diegoargiles/rescu-structures/reports/baseline/load_cases.csv

case | foam | skin_mm | half_force_limit_N | root_moment_limit_Nm | tip_bend_limit_mm | tip_shear_limit_mm | tip_total_limit_mm | tip_twist_limit_deg | max_face_stress_ultimate_MPa | max_torsion_shear_ultimate_MPa | ply_failure_index_ultimate | core_shear_utilization_ultimate | spar_bending_utilization_ultimate | deflection_screen_utilization | twist_screen_utilization | screen_status | overall_status
Wing 3g | Ravatherm XPS X H LB | 0.33 | 55.88340259360954 | 16.598035799563814 | 19.75474637168348 | 4.064735941685093 | 23.819482313368578 | -1.4404386216758196 | 18.46394922169429 | 3.272280001880612 | 0.2927211461975924 | 0.6933226082319038 | 0.42495801101249625 | 0.6805566375248164 | 0.7202193108379098 | PASS | UNRESOLVED: CAD profile, joints, wrinkling, shell and load envelope
Wing -1.5g | Ravatherm XPS X H LB | 0.33 | -27.94170129680477 | -8.299017899781907 | -9.87737318584174 | -2.0323679708425466 | -11.909741156684289 | -0.7704705724954126 | 9.231974610847145 | 1.6300208546258261 | 0.14559914323271644 | 0.3466613041159519 | 0.21247900550624813 | 0.3402783187624082 | 0.3852352862477063 | PASS | UNRESOLVED: CAD profile, joints, wrinkling, shell and load envelope
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
