diegoargiles/rescu-structures/reports/connection_study/attachment_loads.csv

T_N | case | front_N | rear_N | force_on_wing_A_N | force_on_wing_B_N | max_abs_support_N
17.3 | both | 17.3 | 17.3 | 9.885714285714286 | 24.714285714285715 | 24.714285714285715
17.3 | front_only | 17.3 | 0 | 58.078571428571436 | -40.77857142857143 | 58.078571428571436
17.3 | rear_only | 0 | 17.3 | -48.19285714285715 | 65.49285714285715 | 65.49285714285715
17.3 | front_full_rear_half | 17.3 | 8.65 | 33.98214285714286 | -8.032142857142857 | 33.98214285714286
17.3 | front_half_rear_full | 8.65 | 17.3 | -19.153571428571425 | 45.10357142857143 | 45.10357142857143
26.0 | both | 26.0 | 26.0 | 14.857142857142854 | 37.142857142857146 | 37.142857142857146
26.0 | front_only | 26.0 | 0 | 87.28571428571428 | -61.285714285714285 | 87.28571428571428
26.0 | rear_only | 0 | 26.0 | -72.42857142857143 | 98.42857142857143 | 98.42857142857143
26.0 | front_full_rear_half | 26.0 | 13.0 | 51.07142857142857 | -12.071428571428571 | 51.07142857142857
26.0 | front_half_rear_full | 13.0 | 26.0 | -28.785714285714292 | 67.78571428571429 | 67.78571428571429
