diegoargiles/rescu-structures/reports/r13/arm_load_comparison.csv

revision | case | Ffront_limit_N | Frear_limit_N | RA_limit_N | RB_limit_N | max_bending_limit_Nm | section_I_mm4 | axial_stress_limit_MPa | axial_stress_ultimate_MPa | tube_pair_mass_g_rho1600 | front_deflection_mm_E40 | rear_deflection_mm_E40 | front_deflection_mm_E70 | rear_deflection_mm_E70
R12 | balanced_max | 17.3 | 17.3 | 4.942857142857143 | 29.65714285714286 | 2.595 | 12072.0 | 3.224403578528827 | 4.836605367793241 | 107.52000000000001 | 0.02657147393417275 | 0.065383739231279 | 0.015183699390955846 | 0.037362136703588
R12 | front_only | 17.3 | 0 | 42.01428571428572 | -24.714285714285715 | 1.73 | 12072.0 | 2.149602385685885 | 3.224403578528827 | 107.52000000000001 | 0.020301800309255588 | 0.006269673624917149 | 0.011601028748146044 | 0.0035826706428097946
R12 | rear_only | 0 | 17.3 | -37.07142857142857 | 54.371428571428574 | 2.595 | 12072.0 | 3.224403578528827 | 4.836605367793241 | 107.52000000000001 | 0.006269673624917161 | 0.059114065606361815 | 0.0035826706428098085 | 0.03377946606077818
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
