diegoargiles/rescu-structures/archive/v2_v3/ARCHIVE.md

# Historical V2 / H60 V3 reference

These files were moved unchanged from the previous repository root when V4 became current. They document older configurations and are not the current mass/geometry baseline. The old README's branch and run instructions describe that historical state.

Run the current root-level RescU_Structures_V4.py instead. If reproducing the archived V3 tests, change into this directory first, then run `python -m unittest test_v3 -v` so its local imports and airfoil paths resolve.
