diegoargiles/rescu-structures/cad/r13/RescU_R13_New_Parts.step

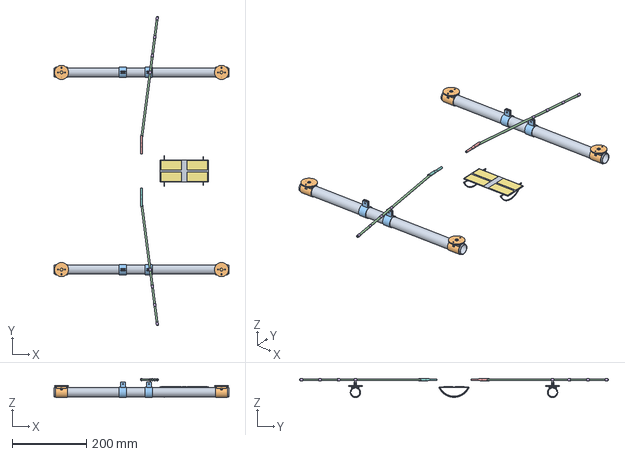
[picture p3: CAD file, 2026-11-06]
cad/r13/RescU_R13_New_Parts.step
470.0 x 830.6 x 51.5 mm
