diegoargiles/rescu-structures/cad/r14_socket_study/RescU_R14_Four_Wing_Sockets.step

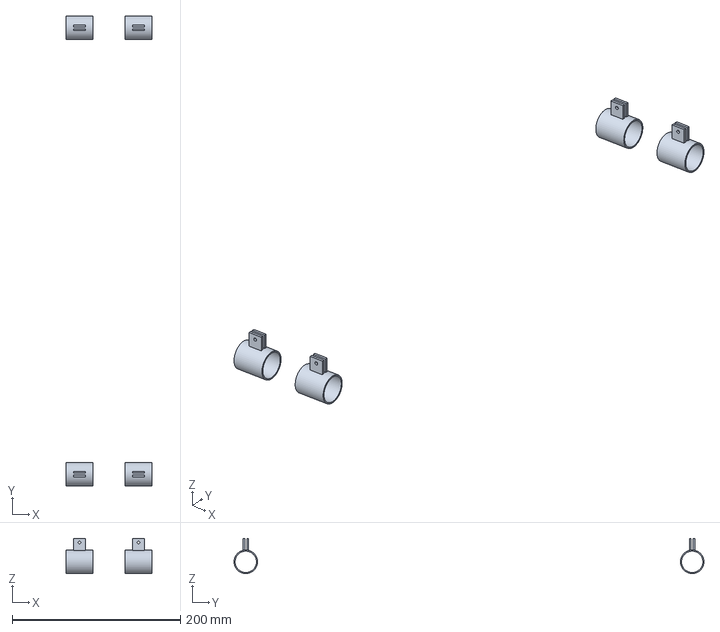
[picture p4: CAD file, 2026-11-06]
cad/r14_socket_study/RescU_R14_Four_Wing_Sockets.step
102.0 x 558.0 x 41.8 mm
