diegoargiles/rescu-structures/cad/r13/mass_changes.csv

part | density_assumed_g_cm3 | R12_volume_mm3 | R13_volume_mm3 | delta_g
Front_ESC_band_2_PosY | 1.15 | 198.79999999999575 | 0 | -0.22861999999999508
Front_ESC_band_2_NegY | 1.15 | 198.7999999999958 | 0 | -0.22861999999999513
Rear_ESC_cushion_PosY | 1.2 | 333.60000000000053 | 0 | -0.4003200000000006
Rear_ESC_cushion_NegY | 1.2 | 333.60000000000053 | 0 | -0.4003200000000006
Forward_clamp_screw_m14p5_PosY | 7.85 | 105.62081625258689 | 0 | -0.8291234075828071
Forward_clamp_screw_m14p5_NegY | 7.85 | 105.62081625258645 | 0 | -0.8291234075828036
Internal_GFRP_sleeve_X235_PosY | 1.9 | 639.3599999999769 | 0 | -1.2147839999999561
Internal_GFRP_sleeve_X235_NegY | 1.9 | 639.3599999999768 | 0 | -1.214783999999956
Forward_lower_keeper_PosY | 2.7 | 1441.3661835060432 | 0 | -3.891688695466317
Forward_lower_keeper_NegY | 2.7 | 1441.366183506097 | 0 | -3.8916886954664625
Aft_clamp_screw_m14p5_PosY | 7.85 | 105.6208162525869 | 0 | -0.8291234075828072
Aft_clamp_screw_m14p5_NegY | 7.85 | 105.62081625258642 | 0 | -0.8291234075828033
Front_ESC_band_1_PosY | 1.15 | 198.79999999999575 | 0 | -0.22861999999999508
Front_ESC_band_1_NegY | 1.15 | 198.7999999999958 | 0 | -0.22861999999999513
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
