diegoargiles/rescu-structures/(commit log)

2026-10-08 Add preliminary foam-core GFRP structural candidate and CAD validation gates
2026-10-19 Make CAD-based V4 current and organize structural analysis repository
    Add P03 material volumes, centroids, mass/CG accounting, structural screens and readable baseline reports. Preserve V2/H60 V3 under archive, separate guides and CAD tools, ignore local outputs, and document the prioritized structural validation plan.
    Validation: V4 run and numerical/accounting checks pass; 17 archived V3 tests pass. Baseline reduced-stiffness twist screen remains failed and overall structural validity unresolved.
    [load_cases.csv, mass_components.csv]
2026-11-06 Document R13 layout and R14 attachment development
    Add CAD build/check scripts, smaller STEP exports, review images, attachment force and torque screens, component-location and mass register, and supplier-backed material/bond/twist candidates. Update README, progress board and CAD distribution manifests; preserve the historical V4/P03 analysis and baseline.
    Validation: numerical equilibrium and support-displacement assertions pass; CG correctly reports incomplete inventory; Python syntax, CAD/check hashes, record counts and relative documentation links checked. Existing targeted geometry records cover 143 R13 and 20 R14 candidate pairs. No structural qualification or assembled R13/R14 FEA i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
    [RescU_R13_New_Parts.step, RescU_R14_Four_Wing_Sockets.step, arm_load_comparison.csv, attachment_loads.csv, cad_component_locations.csv, equipment_mass_location_register.csv, mass_changes.csv]
